Guglielmenzo/TuningFork-Thermometry/sim/ltspice/TuningFork_FrontEnd_Model.asc

C1: cap; 90p
C2: cap; 90p
C3: cap; 90p
C4: cap; 90p
C5: cap; 90p
C6: cap; 90p
C7: cap; 90p
C8: cap; 90p
C_0: cap; .9p
Cc: cap; 1.9p
Cf: cap; 2p
Cm: cap; 2f
Cx: cap; 1p
E1: e; -1
Lm: ind; 11.8k; Rser=1m
R1: res; 6
R2: res; 6
R3: res; 6
R4: res; 6
R5: res; 6
R6: res; 6
R7: res; 6
R8: res; 6
Rf: res; .5Meg
Rm: res; {Rm}
U1: LTC6240
V1: voltage; ""; AC 1 0
Vcc1: voltage; -2.5v
Vcc: voltage; 2.5v
Named nets: +2.5v, 0, -2.5v, Drive
.ac lin 10000 32725 32800
Wire crosstalk
Anti Ringing
Drive twisted pair impedance
Signal twisted pair impedance
Fork Model
This is a model of the tuning fork thermometer front end.
 
The Twisted pair impedances and crosstalk capacitance are 
estimated values and will need further refinement.
 
This model includes a matched capacitance to eliminate 
the internal crosstalk and shunt capacitance.
.step param RM list 10k 50k 250k 1Meg
