Guglielmenzo/TuningFork-Thermometry/(commit log)

2026-10-16 Add sim, signal-processing, and cad folders
    LTspice sims under sim/, MATLAB under signal-processing/, mechanical
    CAD and production outputs under cad/. LTspice .plt files are now kept.
2026-10-16 Add Simulation section describing the tuning fork circuit model
    Documents the Butterworth-Van Dyke equivalent circuit used to model the
    fork and adds its diagram to sim/images.
2026-10-16 Add Blaauwgeers 2007 circuit parameter equations to README
2026-10-16 Add Blaauwgeers circuit-parameter definition of the fork constant
2026-10-16 Add nominal fork equivalent-circuit values to README
2026-10-16 Add LTspice TIA readout simulation of the tuning fork
    Adds the BVD fork model with an LTC6240 transimpedance amplifier
    (Rf stepped over 100, 10k, 100k, 500k), its schematic and AC response
    images, and a README section describing the results.
2026-10-16 Add full front-end LTspice model with shunt compensation
    Models drive/signal twisted pairs, wire crosstalk, and a matched
    compensation capacitor (Cc = C0 + Cx) driven by the inverted drive,
    feeding an LTC6240 TIA. Adds schematic and AC responses with and
    without compensation, and documents them in the README.
2026-10-18 Expand signal-processing README with run loop and signal chain stages
2026-10-18 Add LTspice exported data, front-end noise model, and plot settings
    Exports of V(out) and the noise output for Rf = 50k and 1M, the new
    front-end noise schematic, and the latest front-end schematic and
    plot settings.
2026-10-23 Add first bench measurement: fork with TIA, no anti-ringing capacitor
